pinanshu123/ESP-32-Mixed-Signal-PCB/ESP-32 IoT 4-Layer PCB Schematic.kicad_pcb

## KiCad design ESP-32 IoT 4-Layer PCB Schematic.kicad_pcb (2026-08-25)

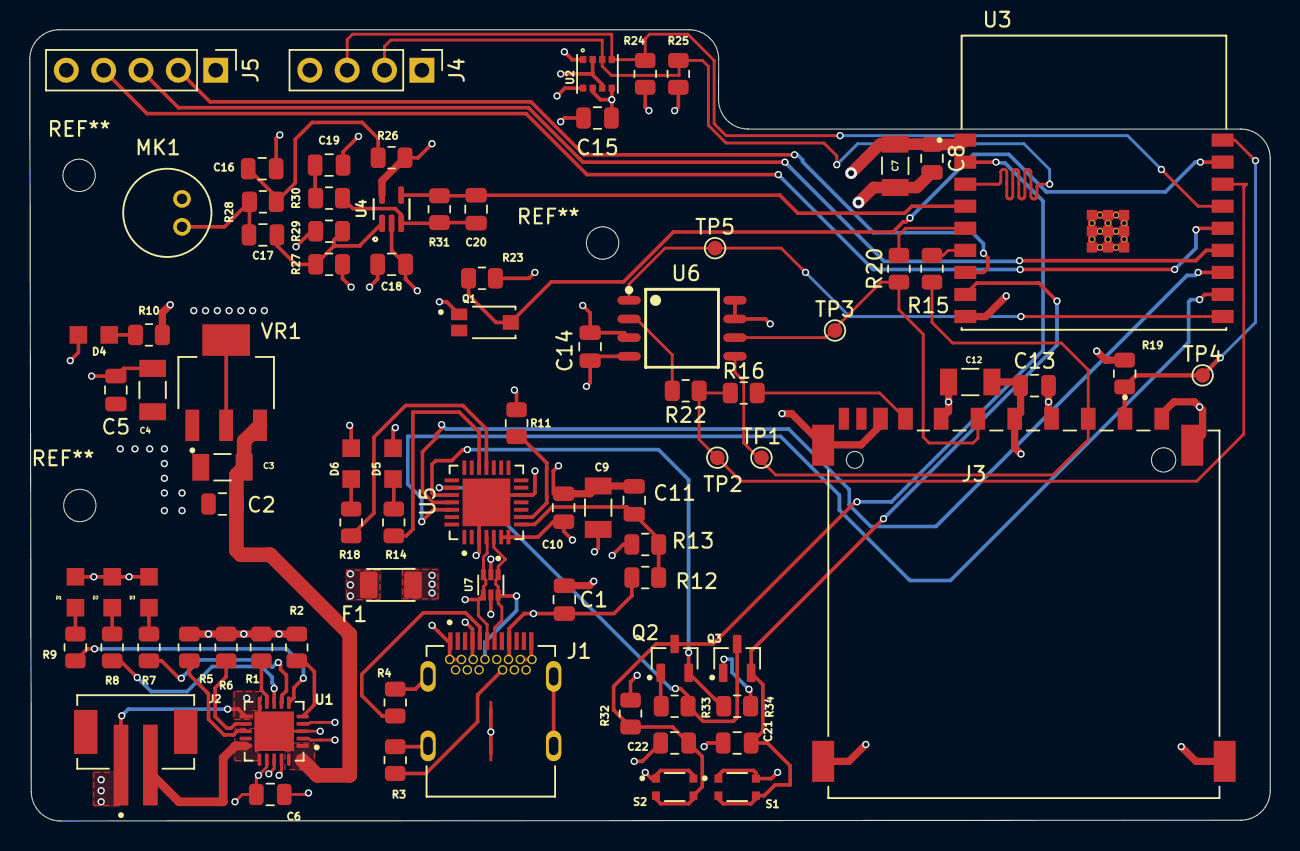
[picture p25: board ESP-32 IoT 4-Layer PCB Schematic.kicad_pcb from above]

Board: 4 copper layers, 84.4 x 53.8 mm, 85 parts (0 on the bottom side), 55 nets.

Parts:
C1, C2, C5, C8, C10, C13, C14, C15, C16, C18, C20, C21: 0.1u; C_0805_2012Metric
C3, C4, C7, C12: 10u; T491A106K010AT7280
C6, C11, C19, C22: 1u; C_0805_2012Metric
C9: 4.7u; T491A106K010AT7280
C17: 10n; C_0805_2012Metric
D1, D4, D6: LTST-C170KRKT
D2, D5: LTST-C170KGKT
D3: LTST-C170TBKT
F1: 0ZCJ0020FF2E; 0ZCJ0025FF2E
J1: SS-52400-003
J2: B2B-PH-SM4-TB_LF__SN_; JST_B2B-PH-SM4-TB
J3: GSD090012SEU
J4: Conn_01x04_Pin; PinHeader_1x04_P2.54mm_Vertical
J5: Conn_01x05_Pin; PinHeader_1x05_P2.54mm_Vertical
MK1: CMC-5042PF-AC; CUI_CMC-5042PF-AC
Q1: TEMT6000X01
Q2, Q3: BC817
R1, R2, R19, R23, R30, R32, R33, R34: 10k; R_0805_2012Metric
R3, R4: 5k1; R_0805_2012Metric
R5, R26, R28: 2k; R_0805_2012Metric
R6: 20k; R_0805_2012Metric
R7, R8, R9, R10, R14, R18: 470; R_0805_2012Metric
R11: 1k; R_0805_2012Metric
R12: 22k1; R_0805_2012Metric
R13: 47k5; R_0805_2012Metric
R15, R16, R20, R22: 50; R_0805_2012Metric
R24, R25: 4k7; R_0805_2012Metric
R27, R29: 1M; R_0805_2012Metric
R31: 100k; R_0805_2012Metric
S1: BOOT; USLPT2819DT2TR
S2: RESET; USLPT2819DT2TR
TP1: Test MOSI_DI; TestPoint_Pad_D1.0mm
TP2: Test MiSO_DO; TestPoint_Pad_D1.0mm
TP3: Test SCLK; TestPoint_Pad_D1.0mm
TP4: Test CS_SD; TestPoint_Pad_D1.0mm
TP5: Test CS; TestPoint_Pad_D1.0mm
U1: MCP73871-2CCI_ML
U2: BME280
U3: ESP32-C3-WROOM-02-H4
U4: MAX4466EXK
U5: CP2102N-A02-GQFN28
U6: W25Q32JVSSIQ
U7: USBLC6-2SC6; USBLC6-2P6
VR1: LM1117MPX-3.3_NOPB

Connections:
+3.3V: C4.1, C5.1, C7.1, C8.1, C9.1, C10.1, C12.1, C13.1, C14.1, C15.1, C18.1, D4.+, D5.+, D6.+, J3.4 (VDD1), J4.1, J5.1, R11.1, R19.2, R23.1, R24.1, R25.1, R26.1, R27.1, R32.1, U2.2 (CSB), U2.6 (VDDIO), U2.8 (VDD), U3.1 (3V3), U4.5 (VCC), U5.6 (VDD), U5.7 (VREGIN), U6.3 (~WP(IO2)), U6.7 (~HOLD/~RESET(IO3)), U6.8 (VCC), VR1.2 (VOUT_2), VR1.4 (VOUT_4)
+5V: C2.1, C3.1, U1.1 (OUT), VR1.3 (VIN)
/+5V_USB: C6.2, D1.+, D3.+, D3.-, F1.2, R7.2, U1.2 (VPCC), U1.4 (PROG2), U1.17 (CE), U1.18 (IN)
/ESP32-C3-02/BOOT: C21.1, Q3.2, S1.3, S1.4, U3.8 (IO9)
/ESP32-C3-02/CS: TP5.1, U3.10 (IO10), U6.1 (~CS)
/ESP32-C3-02/CS_SD: J3.1 (CD/DAT3), R19.1, TP4.1, U3.18 (IO0)
/ESP32-C3-02/DTR: Q3.3, R33.1, U5.23 (CTS)
/ESP32-C3-02/EN: C22.1, Q2.3, R32.2, S2.3, S2.4, U3.2 (EN)
/ESP32-C3-02/GPIO8: J5.2, U3.7 (IO8)
/ESP32-C3-02/GPIO18: J5.3, U3.13 (IO18)
/ESP32-C3-02/GPIO19: J5.4, U3.14 (IO19)
/ESP32-C3-02/MOSI_DI: J3.2 (CMD), R15.2, TP1.1, U6.5 (DI(IO0))
/ESP32-C3-02/MiC_OUT: C20.2, R31.2, U3.4 (IO5), U4.4 (OUT)
/ESP32-C3-02/MiSO_DO: R16.2, R22.1, TP2.1, U3.16 (IO2)
/ESP32-C3-02/Net-(LED5-K): D5.-, R14.2
/ESP32-C3-02/Net-(LED6-K): D6.-, R18.2
/ESP32-C3-02/PHOTO_C: Q1.3, R23.2, U3.17 (IO1)
/ESP32-C3-02/RTS: Q2.2, R34.1, U5.24 (RTS)
/ESP32-C3-02/RX_TX: U3.12 (TXD), U5.25 (RXD)
/ESP32-C3-02/SCL: J4.3, R24.2, U2.4 (SCK), U3.15 (IO3)
/ESP32-C3-02/SCLK: J3.5 (CLK), R20.1, TP3.1, U6.6 (CLK)
/ESP32-C3-02/SDA: J4.2, R25.2, U2.3 (SDI), U3.3 (IO4)
/ESP32-C3-02/TX_RX: U3.11 (RXD), U5.26 (TXD)
/Net-(LED2-K): D2.-, R8.2
/Net-(LED3-K): D1.-, R9.2
/PWD_LED: D4.-, R10.2
/USB_DN: J1.A7 (DN1), J1.B7 (DN2), U5.5 (D-), U7.1 (I/O1), U7.6 (I/O1)
/USB_DP: J1.A6 (DP1), J1.B6 (DP2), U5.4 (D+), U7.3 (I/O2), U7.4 (I/O2)
/VBAT: J2.2, U1.15 (VBAT), U1.16 (VBAT_SENSE)
/VBUS: C1.1, F1.1, J1.A4 (VBUSA1), J1.A9 (VBUSA2), J1.B4 (VBUSB1), J1.B9 (VBUSB2), R12.1, U7.5 (VBUS)
GND: C1.2, C2.2, C3.2, C4.2, C5.2, C6.1, C7.2, C8.2, C9.2, C10.2, C11.2, C12.2, C13.2, C14.2, C15.2, C16.1, C18.2, C19.2, C21.2, C22.2, J1.A1 (GNDA1), J1.A12 (GNDA2), J1.B1 (GNDB1), J1.B12 (GNDB2), J1.G1 (GND/SHIELD), J1.G2 (GND/SHIELD__1), J1.G3 (GND/SHIELD__2), J1.G4 (GND/SHIELD__3), J1.S1 (GND/SHIELD__4), J1.S2 (GND/SHIELD__5), J1.S3 (GND/SHIELD__6), J1.S4 (GND/SHIELD__7), J2.1, J3.3 (VSS1), J3.6 (VSS2), J3.8 (DAT1), J3.9 (DAT2), J3.G1 (SHIELD_GND), J3.G2 (SHIELD_GND__1), J3.G3 (SHIELD_GND__2), J3.G4 (SHIELD_GND__3), J4.4, J5.5, MK1.GND, Q1.1, R1.1, R2.1, R3.2, R4.2, R5.1, R6.1, R10.1, R13.2, R29.2, S1.1, S1.2, S2.1, S2.2, U1.3 (SEL), U1.11 (VSS), U2.1 (GND), U2.5 (SDO), U2.7 (GND__1), U3.9 (GND), U3.19 (GND__1), U3.20 (GND__2), U3.21 (GND__3), U3.22 (GND__4), U3.23 (GND__5), U3.24 (GND__6), U3.25 (GND__7), U3.26 (GND__8), U3.27 (GND__9), U3.28 (GND__10), U3.29 (GND__11), U3.30 (GND__12), U3.31 (GND__13), U3.32 (GND__14), U3.33 (GND__15), U3.34 (GND__16), U3.35 (GND__17), U3.36 (GND__18), U3.37 (GND__19), U3.38 (GND__20), U3.39 (GND__21), U4.2 (GND), U5.3 (GND), U5.12 (SUSPEND), U5.29 (GND__1), U6.4 (GND), U7.2 (GND), VR1.1 (GND)
unnamed: C16.2, R26.2, R28.1
unnamed: C17.1, MK1.OUT, R28.2
unnamed: C19.1, R30.2
unnamed: J1.A5 (CC1), R4.1
unnamed: J1.B5 (CC2), R3.1
unnamed: J3.7 (DAT0), R16.1
unnamed: Q2.1, R33.2
unnamed: Q3.1, R34.2
unnamed: R5.2, U1.13 (PROG1)
unnamed: R6.2, U1.12 (PROG3)
unnamed: R8.1, U1.8 (STAT1/*LBO)
unnamed: R7.1, U1.7 (STAT2)
unnamed: R2.2, U1.5 (THERM)
unnamed: R9.1, U1.6 (~PG)
unnamed: R1.2, U1.9 (~TE)
unnamed: R20.2, U3.5 (IO6)
unnamed: R15.1, U3.6 (IO7)
unnamed: C17.2, R27.2, R29.1, U4.1 (IN+)
unnamed: C20.1, R30.1, R31.1, U4.3 (IN-)
unnamed: R14.1, U5.19 (GPIO.0/TXT)
unnamed: R18.1, U5.18 (GPIO.1/RXT)
unnamed: C11.1, R12.2, R13.1, U5.8 (VBUS)
unnamed: R11.2, U5.9 (~RST)
unnamed: R22.2, U6.2 (DO(IO1))
